adementyev/Motor_Controller_V1/README.md

#Motor Controller V1.0 

##Introduction 
Simple two motor controller and arduino chip in a small package
