adementyev/Motor_Controller_V1/hardware/Schematic_motor_driver_v1.pdf

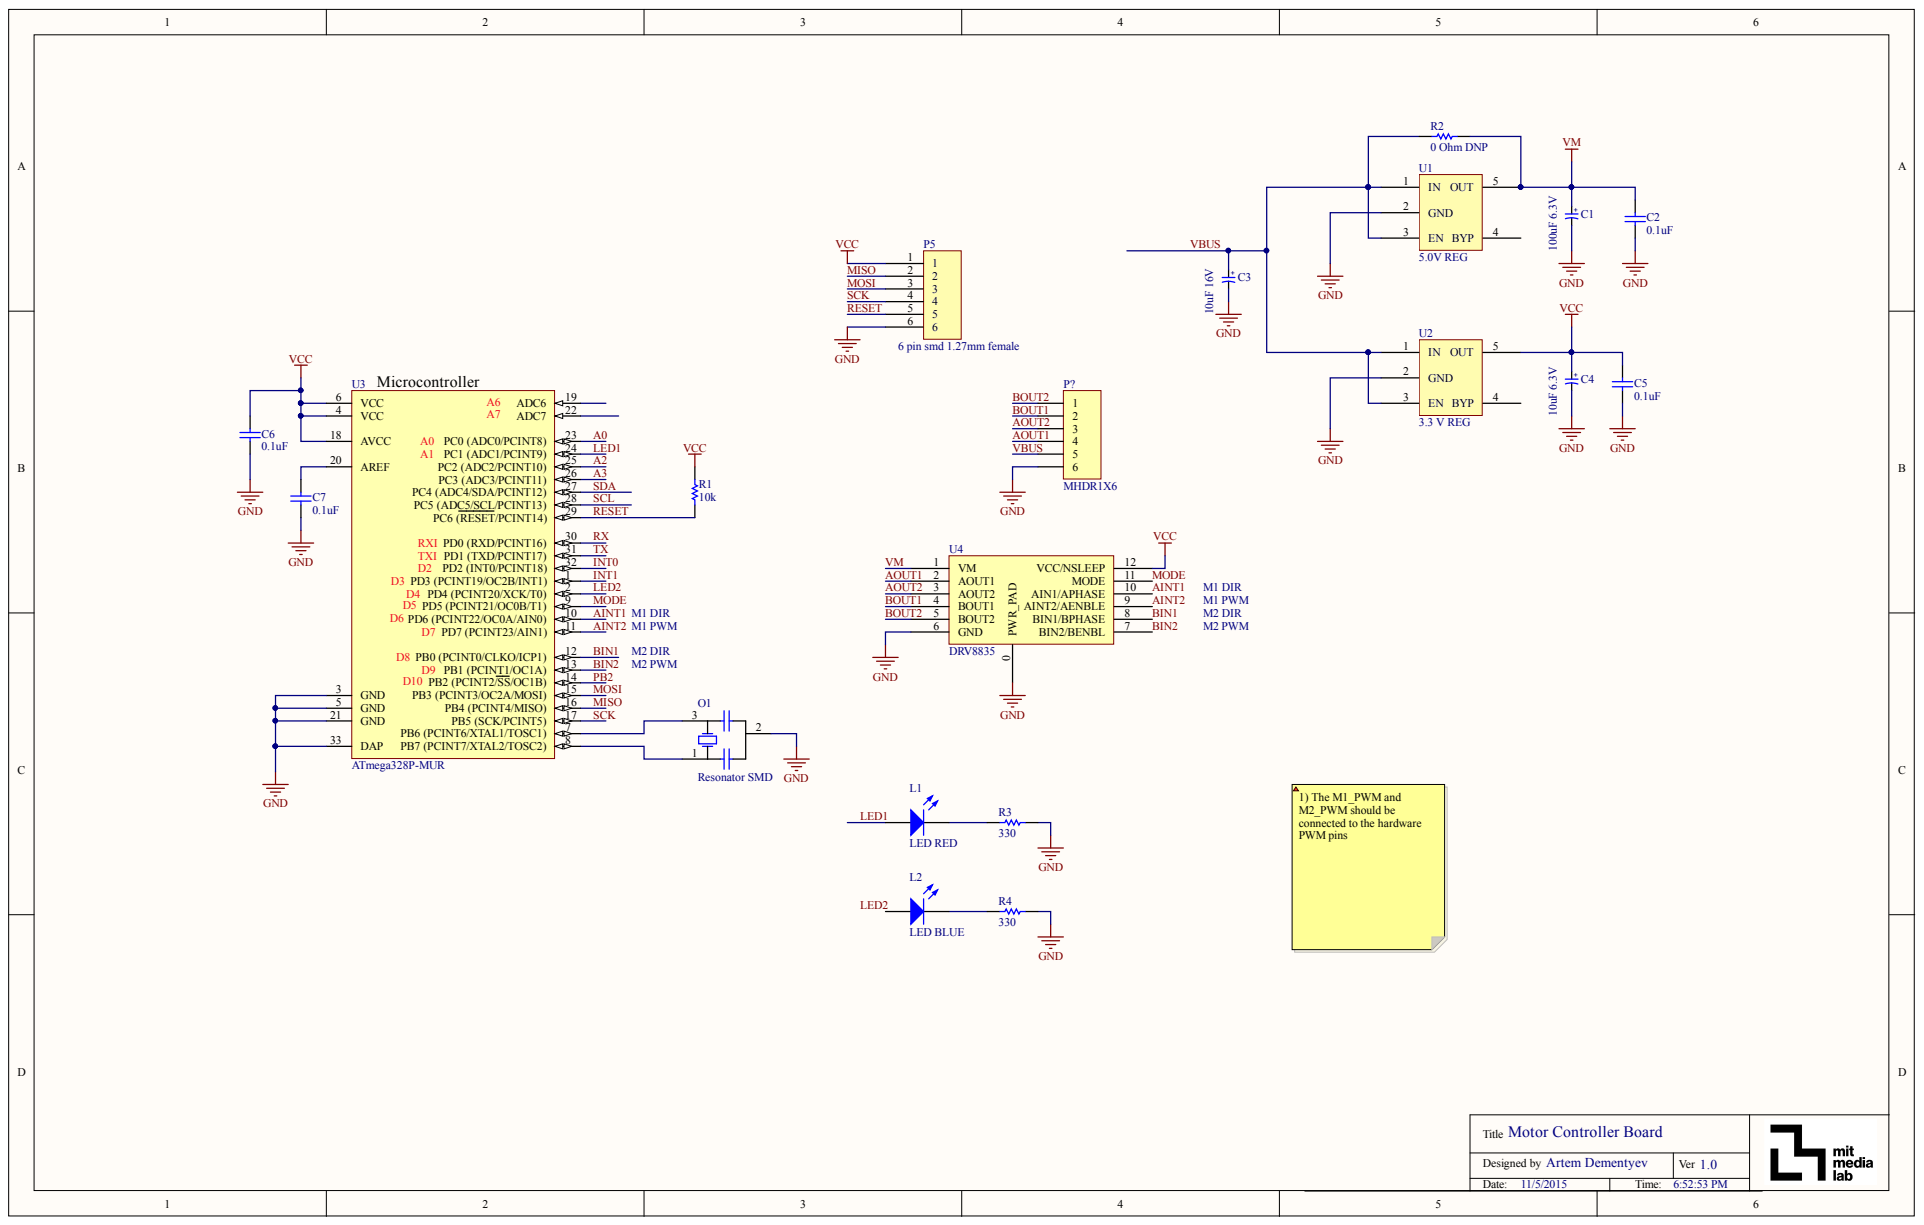
[picture p3: page 1]

Ti t l e Mo t or Co n tro l ler Board

Des igned by A r tem Demen t yev | 1 . 0 Ver

Date: 11/5/2015 | Ti me: 6:52:53 PM
