adementyev/Motor_Controller_V1/(list of files, drawings)

Other design files:
hardware/Motor_driver_V1.PrjPcb
hardware/PCB_motor_driver_V1.PcbDoc
hardware/Schematic_motor_driver_v1.SchDoc
