adementyev/Motor_Controller_V1/(commit log)

2015-11-05 added schematic
2015-11-05 added hardware files
    [Motor_driver_V1.PrjPcb, PCB_motor_driver_V1.PcbDoc, Schematic_motor_driver_v1.SchDoc]
2015-11-06 added arduino file
